TomKeddie/prj-rc2014compat-pico-vga/hardware/rc2014compat-pico-vga.kicad_pcb

## KiCad design hardware/rc2014compat-pico-vga.kicad_pcb (2023-01-23)

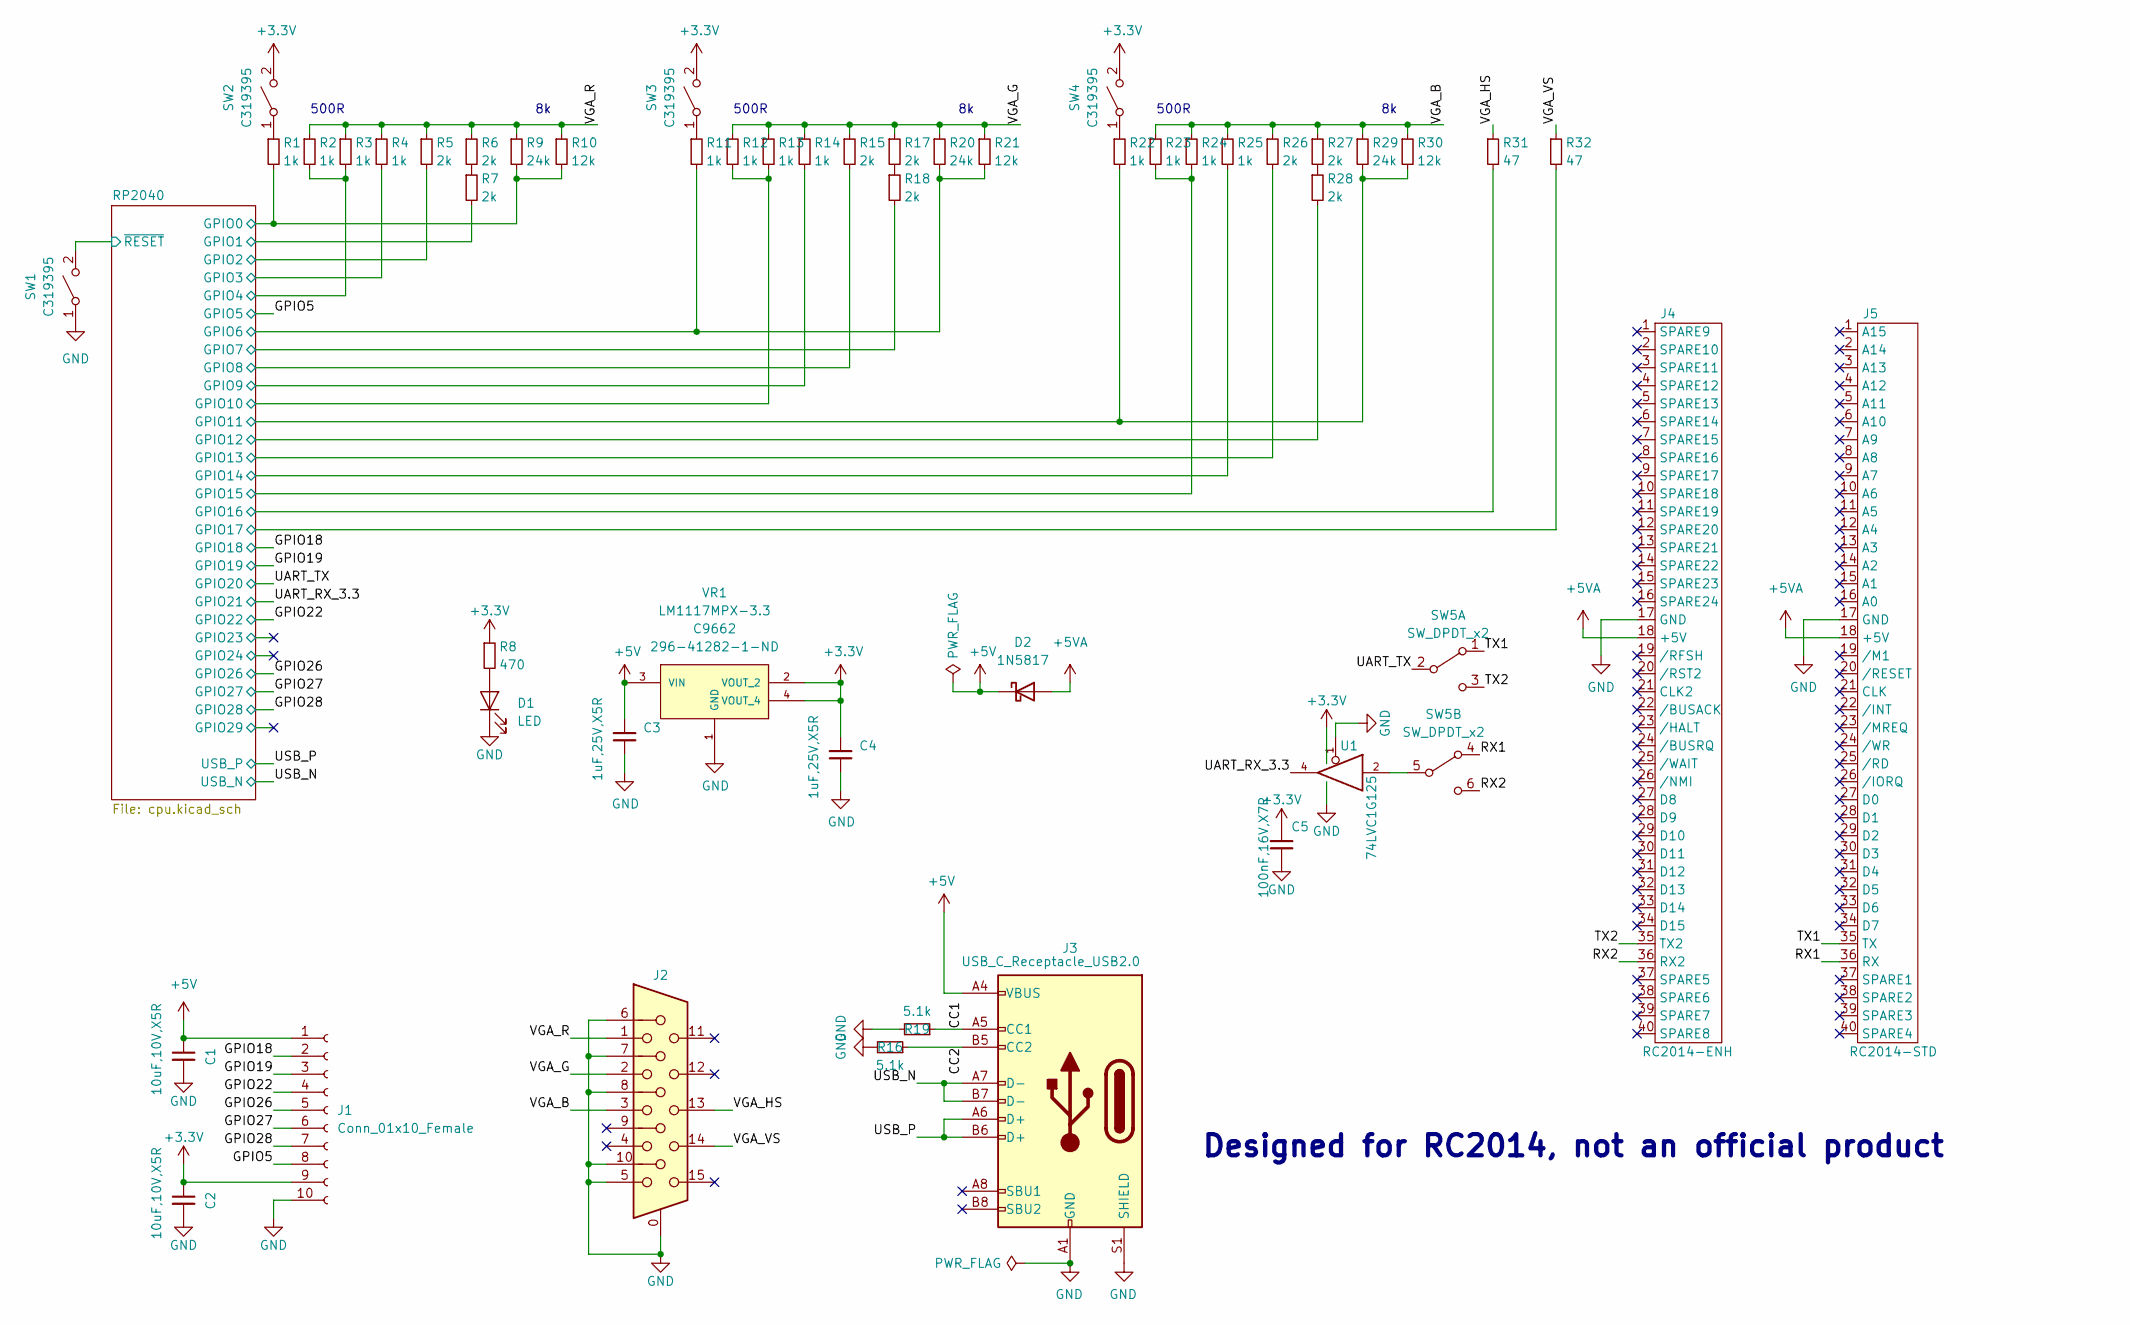
[picture p1: schematic rc2014compat-pico-vga.kicad_sch]

Parts:
C1, C2: 10uF,10V,X5R; C_0603_1608Metric; MFGPN CL10A106KP8NNNC; LCSC C19702
C3, C4: 1uF,25V,X5R; C_0402_1005Metric; MFGPN CL05A105KA5NQNC; LCSC C52923
C5: 100nF,16V,X7R; C_0402_1005Metric; MFGPN CL05B104KO5NNNC; LCSC C1525
D1: LED; LED_0603_1608Metric; LCSC C2286
D2: 1N5817; D_SOD-123; LCSC C727113
J1: Conn_01x10_Female; PinHeader_1x10_P2.54mm_Vertical
J2: DB15_Female_HighDensity_MountingHoles; DSUB-15-HD_Female_Horizontal_P2.29x1.98mm_EdgePinOffset3.03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; LCSC C711364
J3: USB_C_Receptacle_USB2.0; USB_C_Receptacle_GT-USB-7010; LCSC C709357
J4: RC2014-ENH; PinHeader_1x39_P2.54mm_Horizontal
J5: RC2014-STD; PinHeader_1x39_P2.54mm_Horizontal
R1, R2, R3, R4, R11, R12, R13, R14, R22, R23, R24, R25: 1k; R_0402_1005Metric; MFGPN 0402WGF1001TCE; LCSC C11702
R5, R6, R7, R15, R17, R18, R26, R27, R28: 2k; R_0402_1005Metric; MFGPN 0402WGF2001TCE; LCSC C4109
R8: 470; R_0402_1005Metric; MFGPN 0402WGF4700TCE; LCSC C25117
R9, R20, R29: 24k; R_0402_1005Metric; MFGPN 0402WGF2402TCE; LCSC C25769
R10, R21, R30: 12k; R_0402_1005Metric; MFGPN 0402WGF1202TCE; LCSC C25752
R16, R19: 5.1k; R_0402_1005Metric; MFGPN 0402WGF5101TCE; LCSC C25905
R31, R32: 47; R_0402_1005Metric; MFGPN 0402WGF470JTCE; LCSC C25118
SW1, SW2, SW3, SW4: C319395; SW_SPST_SMD_SIDE_C319395; LCSC C319395
SW5: SW_DPDT_x2; SW_DPDT_SMD; LCSC C381098
U1: 74LVC1G125; SOT-23-5
VR1: LM1117MPX-3.3; VREG_LM1117MPX-3.3; PARTREV O; LCSC C9662

Connections:
+3.3V: C2.1, C4.1, C5.1, J1.9, R8.1, SW2.2 (B), SW3.2 (B), SW4.2 (B), U1.5 (VCC), VR1.2 (VOUT_2), VR1.4 (VOUT_4); also elsewhere on the board
+5V: C1.1, C3.1, D2.1 (K), J1.1, J3.A4 (VBUS), J3.A9 (VBUS), J3.B4 (VBUS), J3.B9 (VBUS), VR1.3 (VIN)
+5VA: D2.2 (A), J4.18 (+5V), J5.18 (+5V)
/CC1: J3.A5 (CC1), R19.1
/CC2: J3.B5 (CC2), R16.1
/GPIO5: J1.8; also elsewhere on the board
/GPIO18: J1.2; also elsewhere on the board
/GPIO19: J1.3; also elsewhere on the board
/GPIO22: J1.4; also elsewhere on the board
/GPIO26: J1.5; also elsewhere on the board
/GPIO27: J1.6; also elsewhere on the board
/GPIO28: J1.7; also elsewhere on the board
/RP2040/GPIO0: R1.2, R9.2, R10.2; also elsewhere on the board
/RP2040/GPIO1: R7.2; also elsewhere on the board
/RP2040/GPIO2: R5.2; also elsewhere on the board
/RP2040/GPIO3: R4.2; also elsewhere on the board
/RP2040/GPIO4: R2.2, R3.2; also elsewhere on the board
/RP2040/GPIO6: R11.2, R20.2, R21.2; also elsewhere on the board
/RP2040/GPIO7: R18.2; also elsewhere on the board
/RP2040/GPIO8: R15.2; also elsewhere on the board
/RP2040/GPIO9: R14.2; also elsewhere on the board
/RP2040/GPIO10: R12.2, R13.2; also elsewhere on the board
/RP2040/GPIO11: R22.2, R29.2, R30.2; also elsewhere on the board
/RP2040/GPIO12: R28.2; also elsewhere on the board
/RP2040/GPIO13: R26.2; also elsewhere on the board
/RP2040/GPIO14: R25.2; also elsewhere on the board
/RP2040/GPIO15: R23.2, R24.2; also elsewhere on the board
/RP2040/GPIO16: R31.2; also elsewhere on the board
/RP2040/GPIO17: R32.2; also elsewhere on the board
/RP2040/~RESET: SW1.2 (B); also elsewhere on the board
/RX1: J5.36 (RX), SW5.4 (A)
/RX2: J4.36 (RX2), SW5.6 (C)
/TX1: J5.35 (TX), SW5.1 (A)
/TX2: J4.35 (TX2), SW5.3 (C)
/UART_RX_3.3: U1.4; also elsewhere on the board
/UART_TX: SW5.2 (B); also elsewhere on the board
/USB_N: J3.A7 (D-), J3.B7 (D-); also elsewhere on the board
/USB_P: J3.A6 (D+), J3.B6 (D+); also elsewhere on the board
/VGA_B: J2.3, R23.1, R24.1, R25.1, R26.1, R27.1, R29.1, R30.1
/VGA_G: J2.2, R12.1, R13.1, R14.1, R15.1, R17.1, R20.1, R21.1
/VGA_HS: J2.13, R31.1
/VGA_R: J2.1, R2.1, R3.1, R4.1, R5.1, R6.1, R9.1, R10.1
/VGA_VS: J2.14, R32.1
GND: C1.2, C2.2, C3.2, C4.2, C5.2, D1.1 (K), J1.10, J2.0, J2.5, J2.6, J2.7, J2.8, J2.10, J3.A1 (GND), J3.A12 (GND), J3.B1 (GND), J3.B12 (GND), J3.S1 (SHIELD), J4.17 (GND), J5.17 (GND), R16.2, R19.2, SW1.1 (A), U1.1, U1.3 (GND), VR1.1 (GND); also elsewhere on the board
unnamed: D1.2 (A), R8.2
unnamed: R1.1, SW2.1 (A)
unnamed: R6.2, R7.1
unnamed: R11.1, SW3.1 (A)
unnamed: R17.2, R18.1
unnamed: R22.1, SW4.1 (A)
unnamed: R27.2, R28.1
unnamed: SW5.5 (B), U1.2

Notes on the sheet:
500R
Designed for RC2014, not an official product

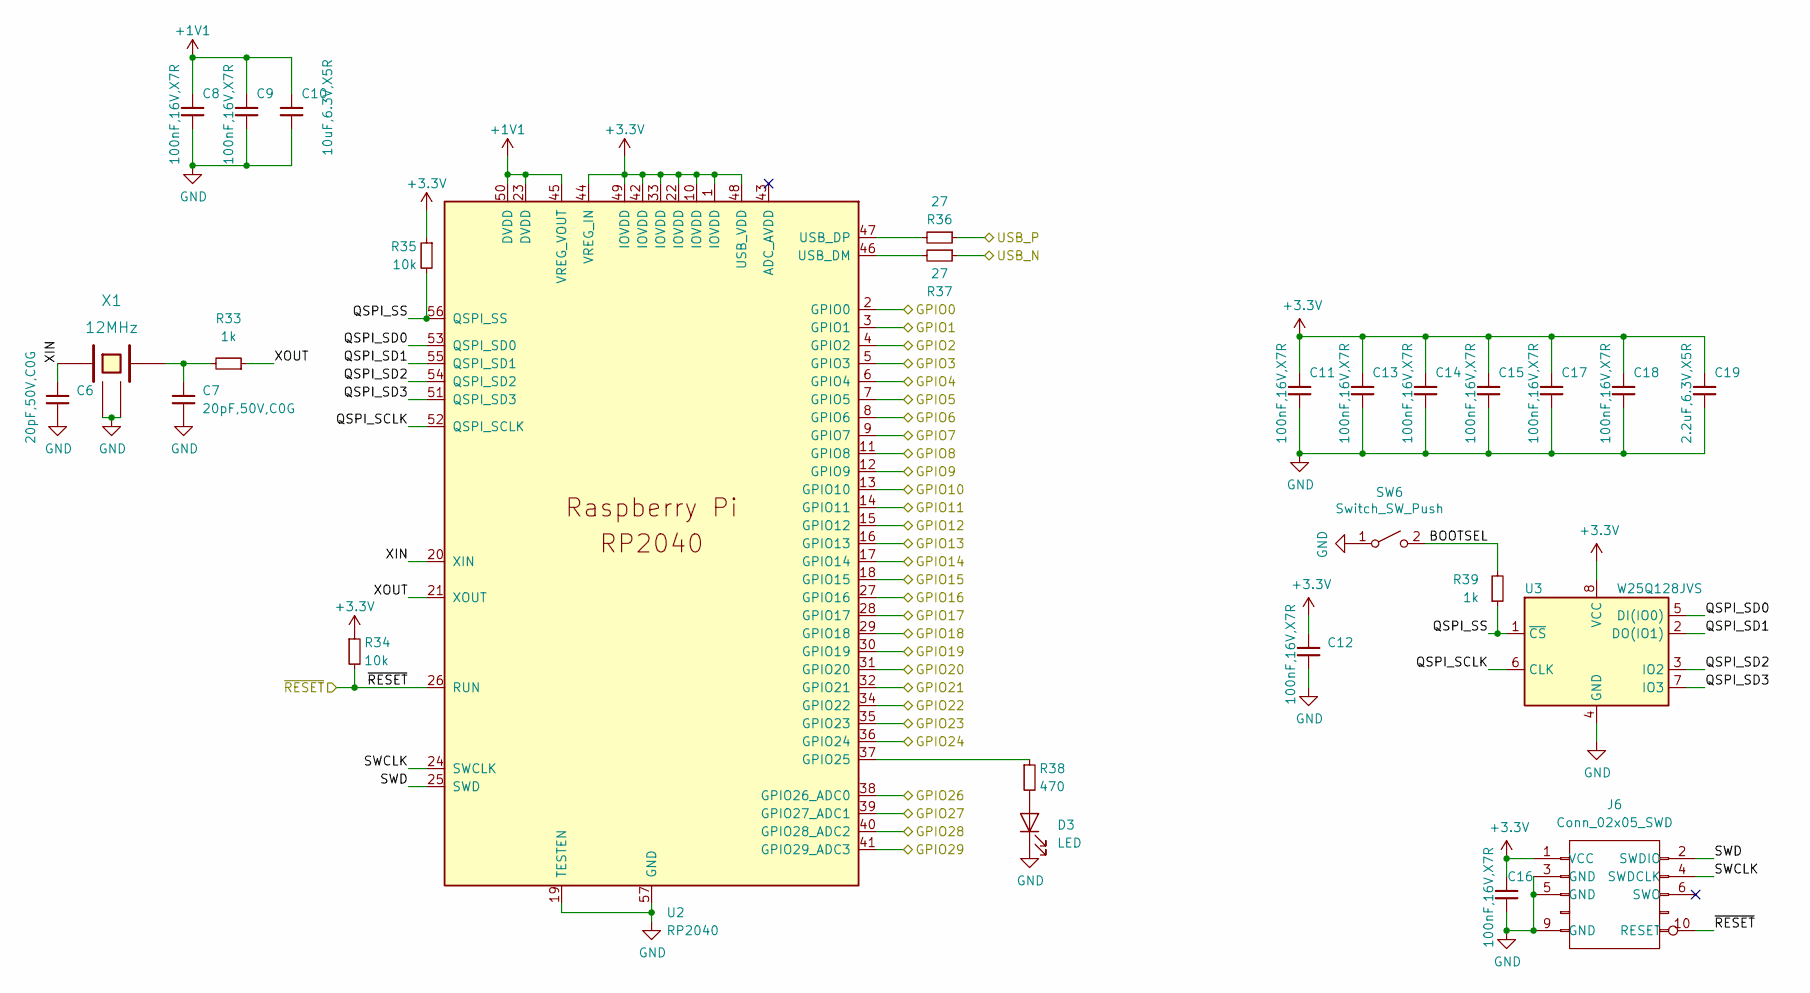
[picture p2: schematic cpu.kicad_sch]

Parts:
C6, C7: 20pF,50V,C0G; C_0402_1005Metric; MFGPN 0402CG200J500NT; LCSC C1554
C8, C9, C11, C12, C13, C14, C15, C16, C17, C18: 100nF,16V,X7R; C_0402_1005Metric; MFGPN CL05B104KO5NNNC; LCSC C1525
C10: 10uF,6.3V,X5R; C_0402_1005Metric; MFGPN CL05A106MQ5NUNC; LCSC C15525
C19: 2.2uF,6.3V,X5R; C_0402_1005Metric; MFGPN CL05A225MQ5NSNC; LCSC C12530
D3: LED; LED_0603_1608Metric; LCSC C2290
J6: Conn_02x05_SWD; FTSH-105-01-F-DV-K
R33, R39: 1k; R_0402_1005Metric; MFGPN 0402WGF1001TCE; LCSC C11702
R34, R35: 10k; R_0402_1005Metric; MFGPN 0402WGF1002TCE; LCSC C25744
R36, R37: 27; R_0603_1608Metric; MFGPN 0603WAF270JT5E; LCSC C25190
R38: 470; R_0402_1005Metric; MFGPN 0402WGF4700TCE; LCSC C25117
SW6: Switch_SW_Push; SW_SPST_SMD_SIDE_C319395; LCSC C319395
U2: RP2040; RP2040-QFN-56; LCSC C2040
U3: W25Q128JVS; SOIC-8_5.23x5.23mm_P1.27mm; LCSC C97521
X1: 12MHz; Crystal_SMD_3225-4Pin_3.2x2.5mm; LCSC C9002

Connections:
+1V1: C8.1, C9.1, C10.1, U2.23 (DVDD), U2.45 (VREG_VOUT), U2.50 (DVDD)
+3.3V: C11.1, C12.1, C13.1, C14.1, C15.1, C16.1, C17.1, C18.1, C19.1, J6.1 (VCC), R34.1, R35.1, U2.1 (IOVDD), U2.10 (IOVDD), U2.22 (IOVDD), U2.33 (IOVDD), U2.42 (IOVDD), U2.44 (VREG_IN), U2.48 (USB_VDD), U2.49 (IOVDD), U3.8 (VCC); also elsewhere on the board
/GPIO5: U2.7 (GPIO5); also elsewhere on the board
/GPIO18: U2.29 (GPIO18); also elsewhere on the board
/GPIO19: U2.30 (GPIO19); also elsewhere on the board
/GPIO22: U2.34 (GPIO22); also elsewhere on the board
/GPIO26: U2.38 (GPIO26_ADC0); also elsewhere on the board
/GPIO27: U2.39 (GPIO27_ADC1); also elsewhere on the board
/GPIO28: U2.40 (GPIO28_ADC2); also elsewhere on the board
/RP2040/BOOTSEL: R39.2, SW6.2 (B)
/RP2040/GPIO0: U2.2 (GPIO0); also elsewhere on the board
/RP2040/GPIO1: U2.3 (GPIO1); also elsewhere on the board
/RP2040/GPIO2: U2.4 (GPIO2); also elsewhere on the board
/RP2040/GPIO3: U2.5 (GPIO3); also elsewhere on the board
/RP2040/GPIO4: U2.6 (GPIO4); also elsewhere on the board
/RP2040/GPIO6: U2.8 (GPIO6); also elsewhere on the board
/RP2040/GPIO7: U2.9 (GPIO7); also elsewhere on the board
/RP2040/GPIO8: U2.11 (GPIO8); also elsewhere on the board
/RP2040/GPIO9: U2.12 (GPIO9); also elsewhere on the board
/RP2040/GPIO10: U2.13 (GPIO10); also elsewhere on the board
/RP2040/GPIO11: U2.14 (GPIO11); also elsewhere on the board
/RP2040/GPIO12: U2.15 (GPIO12); also elsewhere on the board
/RP2040/GPIO13: U2.16 (GPIO13); also elsewhere on the board
/RP2040/GPIO14: U2.17 (GPIO14); also elsewhere on the board
/RP2040/GPIO15: U2.18 (GPIO15); also elsewhere on the board
/RP2040/GPIO16: U2.27 (GPIO16); also elsewhere on the board
/RP2040/GPIO17: U2.28 (GPIO17); also elsewhere on the board
/RP2040/GPIO23: U2.35 (GPIO23)
/RP2040/GPIO24: U2.36 (GPIO24)
/RP2040/GPIO29: U2.41 (GPIO29_ADC3)
/RP2040/QSPI_SCLK: U2.52 (QSPI_SCLK), U3.6 (CLK)
/RP2040/QSPI_SD0: U2.53 (QSPI_SD0), U3.5 (DI(IO0))
/RP2040/QSPI_SD1: U2.55 (QSPI_SD1), U3.2 (DO(IO1))
/RP2040/QSPI_SD2: U2.54 (QSPI_SD2), U3.3 (IO2)
/RP2040/QSPI_SD3: U2.51 (QSPI_SD3), U3.7 (IO3)
/RP2040/QSPI_SS: R35.2, R39.1, U2.56 (QSPI_SS), U3.1 (~CS)
/RP2040/SWCLK: J6.4 (SWDCLK), U2.24 (SWCLK)
/RP2040/SWD: J6.2 (SWDIO), U2.25 (SWD)
/RP2040/XIN: C6.1, U2.20 (XIN), X1.1
/RP2040/XOUT: R33.1, U2.21 (XOUT)
/RP2040/~RESET: J6.10 (RESET), R34.2, U2.26 (RUN); also elsewhere on the board
/UART_RX_3.3: U2.32 (GPIO21); also elsewhere on the board
/UART_TX: U2.31 (GPIO20); also elsewhere on the board
/USB_N: R37.1; also elsewhere on the board
/USB_P: R36.1; also elsewhere on the board
GND: C6.2, C7.2, C8.2, C9.2, C10.2, C11.2, C12.2, C13.2, C14.2, C15.2, C16.2, C17.2, C18.2, C19.2, D3.1 (K), J6.3 (GND), J6.5 (GND), J6.9 (GND), SW6.1 (A), U2.19 (TESTEN), U2.57 (GND), U3.4 (GND), X1.2 (GND), X1.4 (GND); also elsewhere on the board
unnamed: C7.1, R33.2, X1.3
unnamed: D3.2 (A), R38.2
unnamed: R36.2, U2.47 (USB_DP)
unnamed: R37.2, U2.46 (USB_DM)
unnamed: R38.1, U2.37 (GPIO25)

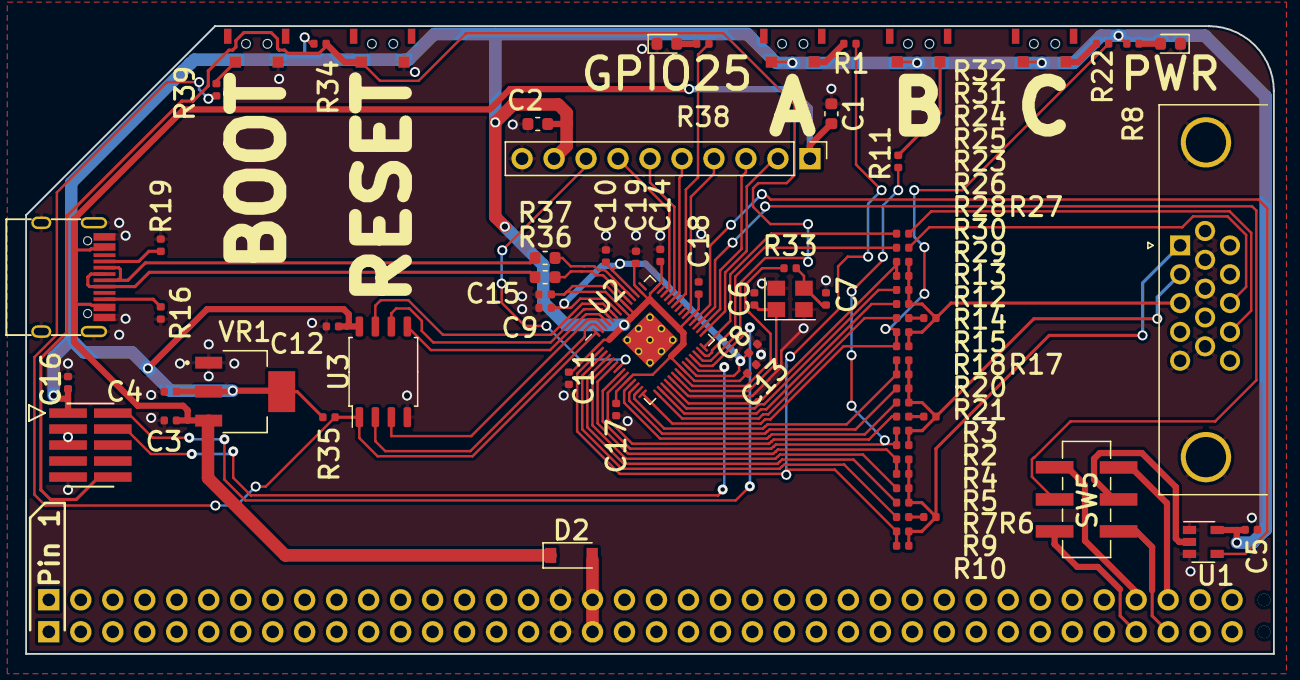
[picture p3: board rc2014compat-pico-vga.kicad_pcb from above]

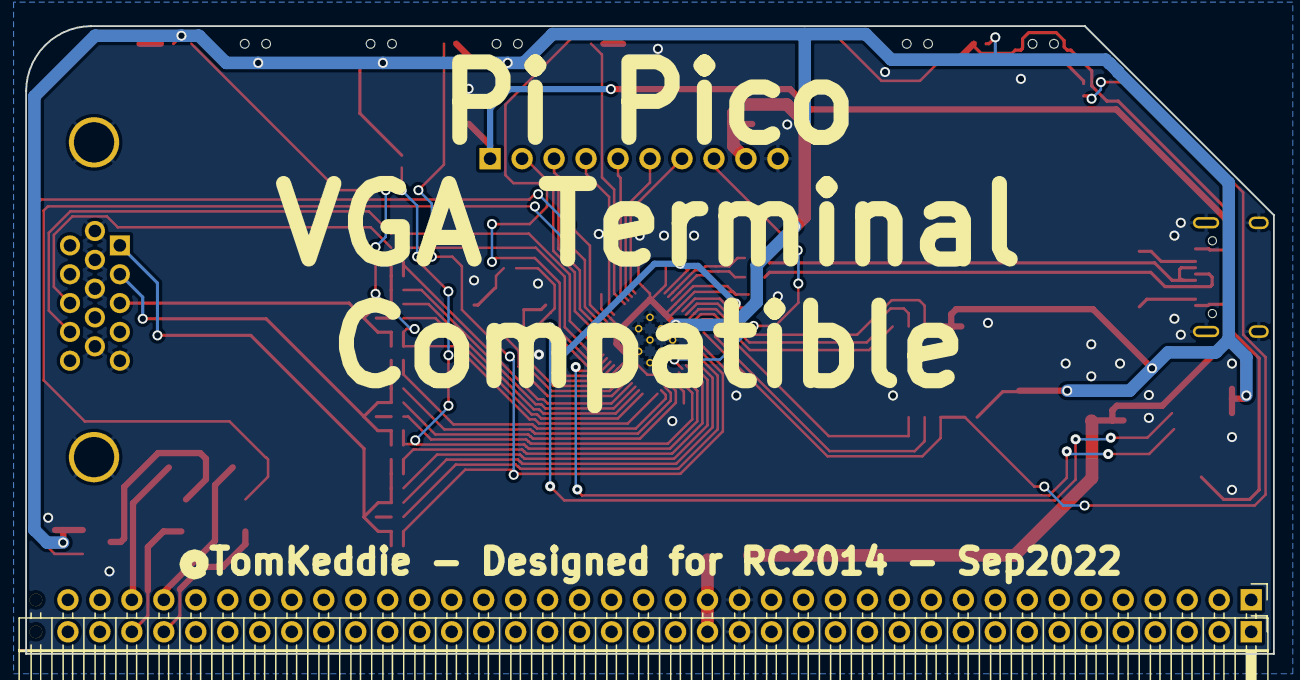
[picture p4: board rc2014compat-pico-vga.kicad_pcb from below]

Board: 2 copper layers, 99.1 x 49.9 mm, 78 parts (2 on the bottom side), 69 nets.
