TomKeddie/prj-rc2014compat-pico-vga/(commit log)

2022-09-23 rc2014compat-pico-vga: pic vga clone designed for RC2014
    [cpu.kicad_sch, rc2014compat-pico-vga.kicad_pcb, rc2014compat-pico-vga.kicad_sch]
2022-09-25 hardware: pcb routing complete
    [cpu.kicad_sch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]
2022-09-25 hardware: add jlcpcb assembly files
    [rc2014compat-pico-vga.csv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]
2022-09-26 hardware: Sep2022 as submitted
    [rc2014compat-pico-vga-CmtUser.gbr, rc2014compat-pico-vga-CuBottom.gbl, rc2014compat-pico-vga-CuTop.gtl, rc2014compat-pico-vga-EdgeCuts.gm1, rc2014compat-pico-vga-MaskBottom.gbs, rc2014compat-pico-vga-MaskTop.gts, rc2014compat-pico-vga-PasteBottom.gbp, rc2014compat-pico-vga-PasteTop.gtp]
2023-01-23 hardware: as submitted to jlcpcb
    [rc2014compat-pico-vga-B_Cu.gbl, rc2014compat-pico-vga-B_Mask.gbs, rc2014compat-pico-vga-B_Silkscreen.gbo, rc2014compat-pico-vga-CmtUser.gbr, rc2014compat-pico-vga-CuBottom.gbl, rc2014compat-pico-vga-CuTop.gtl, rc2014compat-pico-vga-EdgeCuts.gm1, rc2014compat-pico-vga-Edge_Cuts.gm1]
